rcjcooke/apfc/README.md

# apfc
Aeroponics Personal Food Computer
