rcjcooke/apfc/software/aero_ctrl/README.md

# Aeroponics Controller

## References
* [Using Arduino EEPROM for persistent storage of data](https://docs.arduino.cc/learn/built-in-libraries/eeprom)
* [Using the Gradia Flow Sensor](https://forum.arduino.cc/t/flow-meter-with-arduino/964481/15)
* [Using namespaces to group related variables and functions for interrupt routines](https://forum.arduino.cc/t/embedding-interrupts-and-isr-in-a-class/326121/11)
* [Using Lambdas in C++](https://docs.microsoft.com/en-us/cpp/cpp/lambda-expressions-in-cpp?view=msvc-170)
* [Basic lambda implementation without libraries](https://forum.arduino.cc/t/are-anonymous-function-or-lambda-possible-with-uno-yes-solved/420186/13)
* [Using an industrial pressure sensor](https://www.youtube.com/watch?v=junu_66G_QQ)
* [Depth sensor A02YYUW reference - closest I could find to a datasheet](https://wiki.dfrobot.com/_A02YYUW_Waterproof_Ultrasonic_Sensor_SKU_SEN0311#target_0)
* [Library for setting up serial interfaces on other arduino pins](https://docs.arduino.cc/learn/built-in-libraries/software-serial)
* [Serial comms between a Raspberry Pi and an Arduino](https://roboticsbackend.com/raspberry-pi-arduino-serial-communication/)
