rcjcooke/apfc/hardware/datasheets/201801291535346544.jpg

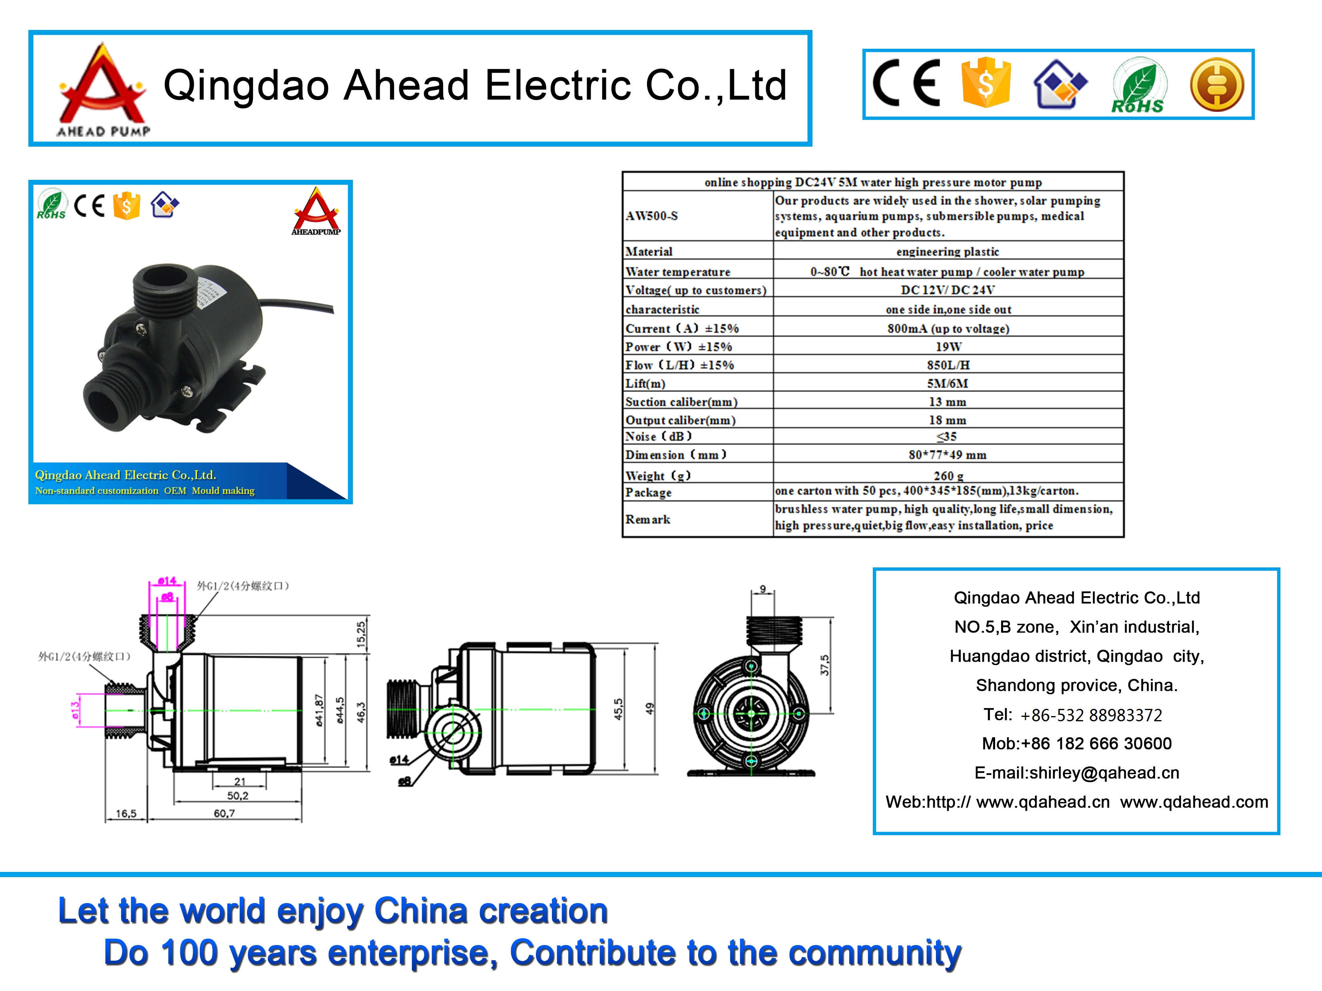
hardware/datasheets/201801291535346544.jpg
