rcjcooke/apfc/V1 BOM.xlsx

Sheet: BOM
Part Description | Manufacturer | Name | Model # | Supplier | # | # / pkg | items | Price / pkg | Total
HPA Irrigation Pump | Aquatec | Aquatec CDP 8800 | 8852-2J03-B424 |  | 1 | 1 | 1 |  | £0.00
3/4" FBSP to 1/4" Push Fit adaptor | John Guest | John Guest Tap Adaptor Flat End 1⁄4″ × 3⁄4″ (BSP Thread) | CI320816FS | Amazon (https://www.amazon.co.uk/John-Guest-BSP-Push-Adapter/dp/B0087OSUY4) | 1 | 1 | 1 | £5.99 | £5.99
1" FBSP to 3/4" MBSP adaptor | BFG | Brass Bush BSP REDUCING Reducer Connector (1"F x 3/4"M) |  | Amazon (https://www.amazon.co.uk/gp/product/B079L84FT8/ref=crt_ewc_title_oth_1) | 1 | 1 | 1 | £7.49 | £7.49
UV Water steriliser |  | UV Water Sterilizer | SDE-011PH | Amazon (https://www.amazon.co.uk/FINERFILTERS-Ultraviolet-Disinfection-Stainless-Sterilizer/dp/B08S7MCFQY) | 1 | 1 | 1 | £48.99 | £48.99
Accumulator Tank | Pressurewave | 8L Accumulation Tank 10bar max working pressure | MTPA-8HL-100BT-1.9-SSC-CSS-AMD-PW (https://www.globalwatersolutions.com/products/pressure-tanks/pump-applications/pressurewave/) | Anglian Plumbing | 1 | 1 | 1 | £54.84 | £54.84
Various fittings + valves | CESFONJER | CESFONJER RO Water Filter Fitting, 1/4" Pushfit Straight Connector for Water Pipe, Push in to Connect Water Tube Fitting Set Pack of 20(Y+T+I+L Type Combo + Shut-Off Valve) |  | Amazon (https://www.amazon.co.uk/gp/product/B07GS1HKCZ/ref=crt_ewc_title_oth_2) | 1 | 20 | 20 | £11.99 | £11.99
Pressure Gauge | Finerfilters | Pressure gauge with 1/4" push fit connections | 5060513511887 | Amazon (https://www.amazon.co.uk/Pressure-Aquatic-Domestic-Connection-Finerfilters/dp/B078WCFHNM) | 1 | 1 | 1 | £8.99 | £8.99
Pressure sensor | Ausla | Pressure Sensor, PSI Pressure Transmitter, G1 / 4 Inch 5 V Transducer for Water Gas Oil (0-150 PSI) | DE-GS07381 | Amazon (https://www.amazon.co.uk/Pressure-pressure-transmitter-transducer-0-100PSI/dp/B0811HPGZ3) | 1 | 1 | 1 | £16.29 | £16.29
G1/4 Female to 1/4" Push Fit adaptor | Sourcingmap | sourcingmap 1/4-inch Push Fit Tube x G1/4 Female Thread Quick Connect 5pcs | ‎A17040800ux1814 | Amazon (https://www.amazon.co.uk/sourcingmap%C2%AE-4-inch-Female-Thread-Connect/dp/B073V1DQFW/ref=sr_1_3) | 1 | 5 | 5 | £8.49 | £8.49
Flow sensor | Gredia | GREDIA 1/4" Quick Connect Water Flow Sensor Food-grade Switch Hall Effect Flowmeter Fluid Meter Counter 0.3-6L/min (Pack of 2) | ‎GR-402BP2 | Amazon (https://www.amazon.co.uk/gp/product/B07RD4JXLY) | 1 | 2 | 2 | £8.49 | £8.49
1/4" tubing white | John Guest | 1/4 FRIDGE FILTER TUBING LLDPE WATER PIPE John Guest JG 10m WHITE by John Guest | PE08BI0500FBX10M | Amazon (https://www.amazon.co.uk/FRIDGE-FILTER-TUBING-LLDPE-WATER/dp/B00JF1O7UY/ref=sr_1_1) | 1 | 1 | 1 | £7.98 | £7.98
Pressure Release Valve 8 bar | Afriso | 1/2" x 3/4" Boiler Safety Pressure Release Relief Reducing Valve FxF Female 8 Bar | 642415254519 | Amazon (https://www.amazon.co.uk/Boiler-Safety-Pressure-Release-Reducing/dp/B079Q8RVYR/ref=sr_1_5) | 1 | 1 | 1 | £14.99 | £14.99
1/2" MBSP to 1/2" MBSP adaptor | CYUaoao | CYUaoao Faucet Adapter 3Pcs Hex Nipple Brass Pipe Fitting 1/2"(20mm) BSP Male to Male Straight Pipe Hex Fitting Heavy Pipe Metals External Hex Nipple for Connecting to Female Threaded Pipes (DN15) |  | Amazon (https://www.amazon.co.uk/gp/product/B0995N9WZD/ref=sw_img_1?smid=AGFU543GC4OL1&psc=1) | 1 | 3 | 3 | £8.09 | £8.09
1/2" FBSP to 1/4" Push Fit adaptor | John Guest | JOHN GUEST PIPE CONNECTOR. Push-fit Tube O.D. 1/4" to 1/2" BSP Thread. Speedfit Part No CI320814S. Inch Size Threaded Acetal Fittings for Drinks Dispensers and Pure Water. |  | Amazon (https://www.amazon.co.uk/CONNECTOR-Push-fit-Speedfit-CI320814S-Dispensers/dp/B00HVFWE1K) | 6 | 1 | 6 | £6.24 | £37.44
3/4" MBSP to 1/2" MBSP adaptor | Her Kindness | Brass Hexagon Reducer 3/4” to 1/2” BSP, Her Kindness 2 Pcs Brass Bsp Reducing Connector, 1/2 inch Male to 3/4 inch Adaptor, Brass Reducing Double Nipple 3/4" x 1/2" Male to Male |  | Amazon (https://www.amazon.co.uk/gp/product/B08GC8SXYL/ref=sw_img_1?smid=ANDZAHJFWVWB4&psc=1) | 1 | 1 | 1 | £8.99 | £8.99
Used water filter | Sinolofty | Sinolofty Pipeline Filter, 1/2 Inch Water Pump Filter with 100 Mesh Stainless Steel Strainer, Inline Mesh Screen, Water Pump Filter for Garden Irrigation |  | Amazon (https://www.amazon.co.uk/gp/product/B097H5L5NC/ref=crt_ewc_title_oth_1) | 1 | 1 | 1 | £9.59 | £9.59
Tank pump | HSeaMall | HSEAMALL Brushless Submersible Water Pump DC 12V Amphibious Pump 800L/H 5M for Pond Aquarium Fish Tank Solar Fountain Pool Water Circulation System |  | Amazon (https://www.amazon.co.uk/gp/product/B07L89V1N6/ref=crt_ewc_title_dp_2) | 2 | 1 | 2 | £17.99 | £35.98
1/4" Solenoid valve | Gredia | GREDIA 1/4" DC 12V Solenoid Valve N/C Normally Closed Water Inlet Flow Switch | GRS01 | Amazon (https://www.amazon.co.uk/gp/product/B08KS5MMYK/ref=sw_img_1) | 3 | 1 | 3 | £6.59 | £19.77
1/4" Push Fit 90 elbows | CESFONJER | CESFONJER 1/4-1/4, 90° Elbow Connector | 1/4" to 1/4" Pushfit Fittings | Ro Water Filter Fitting | for Water Filter Dispensers and Reverse Osmosis (12 Pcs) |  | Amazon (https://www.amazon.co.uk/dp/B07QLX7VT5/ref=sspa_dk_detail_0) | 2 | 12 | 24 | £7.99 | £15.98
1/4" Push Fit Tee joints | CESFONJER | CESFONJER Tee 1/4-Inch Reverse Osmosis Tubing Connector | Fridge Filter Plumbing Kit | 1/4" To 1/4" Pushfit Fittings | ro water filter fitting | for Water Filter Dispensers and Reverse Osmosis(10 Pcs) |  | Amazon (https://www.amazon.co.uk/KINYOOO%C2%AE-Connector-Plumbing-Fittings-Dispensers/dp/B07QLX7NYV) | 1 | 10 | 10 | £7.99 | £7.99
Spray nozzles | Sourcingmap | sourcing map G1/4 Mist Nozzle - 0.7mm Orifice Dia Brass Fine Atomizing Spray Tip |  | Amazon (https://www.amazon.co.uk/gp/product/B07W61FVC7/ref=crt_ewc_title_oth_1) | 4 | 1 | 4 | £9.49 | £37.96
1/4" tubing red | John Guest | 1/4" FRIDGE FILTER TUBING LLDPE WATER PIPE John Guest JG 15m RED |  | Amazon (https://www.amazon.co.uk/gp/product/B00JF210DK/ref=crt_ewc_title_oth_1) | 1 | 1 | 1 | £8.10 | £8.10
Tank Depth sensors | DollaTek | DollaTek DC 5V Waterproof Ultrasonic Distance Sensor Measuring Ranging Transducer Module with 2.5M Cable for Arduino |  | Amazon (https://www.amazon.co.uk/gp/product/B07PMGJ231/ref=crt_ewc_title_oth_1) | 3 | 1 | 3 | £10.99 | £32.97
Tanks (Used Solution, Mixing) | IKEA | SOCKERBIT Storage box with lid, grey-green, 38x25x15 cm | 605.140.68 | IKEA (https://www.ikea.com/gb/en/p/sockerbit-storage-box-with-lid-grey-green-60514068/) | 2 | 1 | 2 | £6.00 | £12.00
Plant Bed Tank | IKEA | SAMLA Box, transparent, 78x56x43 cm/130 l | 901.029.71 | IKEA (https://www.ikea.com/gb/en/p/samla-box-transparent-90102971/) | 1 | 1 | 1 | £13.50 | £13.50
Drain flange | Kockney Koi Yamitsu | 1.5" Solvent Weld Flange Tank/Liner Connector Pond Fitting | KKTLC1.5 | Discount Leisure Products (https://www.discountleisureproducts.co.uk/pond-supplies-c1/pond-pipe-and-fittings-c20/kockney-koi-yamitsu-1-5-solvent-weld-flange-tank-liner-connector-pond-fi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) | 1 | 1 | 1 | £4.49 | £4.49
Drain pipe | DLP | 1.5" (40mm) Solvent Weld Pipe 1 metre | W539 | Discount Leisure Products (https://www.discountleisureproducts.co.uk/pond-supplies-c1/pond-pipe-and-fittings-c20/solvent-weld-pipe-fittings-c89/dlp-1-5-43mm-solvent-weld-pipe-1-metre-p1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) | 1 | 1 | 1 | £4.29 | £4.29
RunOff Drain Tank Connector | Kockney Koi Yamitsu | 1.5" Solvent Weld Threaded Tank Connector Fish Pond Fitting | KK158 | Discount Leisure Products (https://www.discountleisureproducts.co.uk/pond-supplies-c1/pond-pipe-and-fittings-c20/solvent-weld-pipe-fittings-c89/kockney-koi-yamitsu-1-5-solvent-weld-thre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) | 1 | 1 | 1 | £1.89 | £1.89
1.5" drain pipe 90 elbows | DLP | 1.5" Solvent Weld 90 Degree Swept Elbow/Bend | W79 | Discount Leisure Products (https://www.discountleisureproducts.co.uk/pond-supplies-c1/pond-pipe-and-fittings-c20/solvent-weld-pipe-fittings-c89/dlp-1-5-solvent-weld-90-degree-swept-elbo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) | 2 | 1 | 2 | £1.99 | £3.98
Drain pipe glue | Hunter Plastics | 125ml Solvent Pipe Glue/Cement | KKGLUE125ML | Discount Leisure Products (https://www.discountleisureproducts.co.uk/pond-supplies-c1/pond-pipe-and-fittings-c20/solvent-weld-glue-c85/hunter-plastics-125ml-solvent-pipe-glue-cement-p1454) | 1 | 1 | 1 | £6.49 | £6.49
Filter pipes (1/2" 60mm MBSPT at both ends) | Double4love | Double4love 1/2"X60mm Barrel Nipple Stainless Steel 316L BSPT Threaded |  | Amazon (https://www.amazon.co.uk/gp/product/B07FP7MNB5/ref=ppx_yo_dt_b_asin_title_o00_s00) | 2 | 1 | 2 | £8.87 | £17.74
1/4" pipe glands | Sourcingmap | sourcing map 8Pcs PG7 Cable Gland Waterproof Connector Plastic Wire Glands Joints White for 3-6.5mm Dia Wires | A18032200ux0204 | Amazon (https://www.amazon.co.uk/gp/product/B07DC74Q7B/ref=ppx_yo_dt_b_asin_title_o03_s00) | 2 | 8 | 16 | £7.49 | £14.98
12V power supply 90W | RS Pro | RS PRO DIN Rail Power Supply 120 → 370 V dc, 85 → 264 V ac Input, 12V Output, 7.5A 90W | LI100-20B12PR2 | RS (https://uk.rs-online.com/web/p/din-rail-power-supplies/1904201) | 1 | 1 | 1 | £30.00 | £30.00
24VAC Transformer 100W | Comatec | Comatec 100VA DIN Rail Transformer, 230V ac Primary, 24V ac Secondary | TBD2.0100.24.F8 | RS (https://uk.rs-online.com/web/p/din-rail-transformers/8919236) | 1 | 1 | 1 | £53.90 | £53.90
5V power supply 15W | RS Pro | RS PRO DIN Rail Power Supply 120 → 370 V dc, 85 → 264V ac Input, 5V Output, 3A 15W | 190-4190 | RS (https://uk.rs-online.com/web/p/din-rail-power-supplies/1904190) | 1 | 1 | 1 | £17.05 | £17.05
DIN Rail | Fibox | Fibox Steel Unslotted Din Rail, Top Hat Compatible, 335mm x 35mm x 8mm | EKV 32 DIN-35 rail | RS (https://uk.rs-online.com/web/p/din-rails/1882550) | 1 | 1 | 1 | £5.18 | £5.18
White 50mm cable trunking | Wickes | Wickes Maxi Trunking - White 50 x 50mm x 2m | 109653 | Wickes (https://www.wickes.co.uk/Wickes-Maxi-Trunking---White-50-x-50mm-x-2m/p/109653) | 2 | 1 | 2 | £14.90 | £29.80
5 Stage RO system | Finerfilters | 5 STAGE REVERSE OSMOSIS SYSTEM WITH BOOSTER PUMP 50GPD ¦ UNDER SINK HOME DOMESTIC | FF-RO-SYST-D5-PUMP | Finerfilters (https://www.finerfilters.co.uk/finerfilters-domestic-5-stage-reverse-osmosis-unit-with-pump.html) | 1 | 1 | 1 | £139.99 | £139.99
Additional RO membrane | Finerfilters | REVERSE OSMOSIS ADDITIONAL MEMBRANE UPGRADE KIT | FF-RO-MEMB-UPG-KIT | Finerfilters (https://www.finerfilters.co.uk/reverse-osmosis-additional-membrane-upgrade-kit.html) | 1 | 1 | 1 | £27.99 | £27.99
Supply and Waste Water Tanks | Tanks Direct | 28 LITRE WATER TANK, TOWER | T28TNA4V | TanksDirect (https://www.tanks-direct.co.uk/28-litre-water-tank-tower/p6200) | 2 | 1 | 2 | £57.60 | £115.20
One way gas valve for nutrient flasks | LiebeWH | 12PCS Aquarium Check Valve Non Return Flows Control Check Valve One Way Air Valve PP for Fish Tank Chemical Industry (4mm) | ‎LiebeWHrb18hpo4zx2561-11 | Amazon (https://www.amazon.co.uk/dp/B0B15HJTC5/ref=sspa_dk_detail_10) | 1 | 12 | 12 | £6.34 | £6.34
Nutrient bottles | Octopus | Wide-neck bottles with screw caps, chemical bottle, laboratory bottle with lid, storage container for laboratory, kitchen or hobby, pack of 10, transparent, 10x 500 ml | PLFWH500-10 | Amazon (https://www.amazon.co.uk/dp/B076H8M48N/ref=sspa_dk_detail_4) | 1 | 10 | 10 | £32.10 | £32.10
Nutrient pumps | Gikfun | Gikfun 12V Peristaltic Liquid Pump Dosing Pump with Replacement for Aquarium Lab Analytical DIY EK1978 (2) | EK1978 | Amazon (https://www.amazon.co.uk/gp/product/B0BNH5S25M/ref=sw_img_1) | 4 | 2 | 8 | £19.98 | £79.92
Nutrient pipe |  | JINchao-clear plastic hose 1/5/10Meters Silicone Tube, 2x4mm, High And Low Temperature Resistance Tasteless Transparent Hose Pipe Plastic Flexible Water Pipe (Color : Green, Length : 10Meters) | Pangocho | Amazon (https://www.amazon.co.uk/gp/product/B09291JJHB/ref=sw_img_1) | 1 | 1 | 1 | £18.47 | £18.47
RO Water tank air valve extension | Zsanhua | Zsanhua Tire Valve Extension 2 Pieces 180 mm, Flexible Valve Stem Extenders with 2 Pieces 90 Degree Brass Tire Valve Extension Adaptor Compatible for Cars Truck Motorcycle Bike Scooter | DG257 | Amazon (https://www.amazon.co.uk/Zsanhua-Extension-Extenders-Compatible-Motorcycle/dp/B0BG4CFX3J) | 1 | 2 | 2 | £8.99 | £8.99
Stop cap for waste water valve | ‎LP Supplies | Brass Blanking Caps 1/2" (Pack of 3) with Washers for 15mm Compression Fittings | 10070227 | Amazon (https://www.amazon.co.uk/dp/B083SMC9VD) | 1 | 3 | 3 | £4.39 | £4.39
TDS sensors for filter change checking | CQRobot | CQRobot Ocean: TDS (Total Dissolved Solids) Meter Sensor Compatible with Raspberry Pi/Arduino Board. for Liquid Quality Analysis Teaching, Scientific Research, Laboratory, Online Analysis, etc. | CQRSENTDS01 | Amazon (https://www.amazon.co.uk/dp/B08KXRHK7H) | 2 | 1 | 2 | £10.99 | £21.98
Waste water tap | RMTL | RMTL Outdoor Garden Tap Hose Union Bib Tap 1/2inch BSP with Compression Wallplate Elbow, Through The Wall 15mm Copper Tube (Single Bib Tap) |  | Amazon (https://www.amazon.co.uk/dp/B0B36HNGV4?th=1) | 1 | 1 | 1 | £8.99 | £8.99
Plumbing bracket mounting screws | Sourcingmap | Sourcingmap 50 Pcs M2 x 15mm Stainless Steel Phillips Round Head Self Tapping Screws Bolts | a16072200ux0833 | Amazon (https://www.amazon.co.uk/gp/product/B01LXFY42N/ref=ppx_yo_dt_b_asin_title_o02_s00?ie=UTF8&psc=1) | 1 | 50 | 50 | £5.99 | £5.99
Water temperature sensor | Aideepen | Aideepen 5 x DS18B20 2m Cable Temperature Digital Thermal Probe Sensor Stainless Steel Probe, Accurate Reading, Measure Temperature -55°C to +125°C | A70110795UK | Amazon (https://www.amazon.co.uk/Aideepen-DS18B20-Temperature-Stainless-Accurate/dp/B08DJ5D5WM) | 1 | 5 | 5 | £11.99 | £11.99
Nutrient solution heater | Hidom | Hidom 25w Submersible Aquarium Fish Tank Shockproof Thermostat Heater - Adjustable Temperature HT-2025 | ‎HT-2025-U | Amazon (https://www.amazon.co.uk/gp/product/B011G5B7EA) | 1 | 1 | 1 | £10.45 | £10.45

Sheet: Power Supplies
 |  | V | DC/AC | Power / W | # | Total Power / W | Total Current / A
Irrigation | Valve | 12 | DC | 4.8 | 2 | 9.6 | 0.40 | V / V | DC | AC | Power / W | Current / A
 | Pump | 24 | AC | 40 | 1 | 40 | 1.67 | 12 | DC | 47.6 | 3.97
 | Flow Sensor | 5 | DC |  |  | 0 | 0.00 | 5 | DC | 0 | 0.00
 | Pressure Sensor | 5 | DC |  |  | 0 | 0.00 | 240 | AC | 14 | 0.06
RunOff Recycling | Pump | 12 | DC | 19 | 1 | 19 | 1.58 | 24 | AC | 40 | 1.67
 | UV Lamp | 240 | AC | 14 | 1 | 14 | 0.06 |  |  | 101.6
Nutrient Mixing | Pump | 12 | DC | 19 | 1 | 19 | 1.58

Sheet: Electronics
Part Description | Manufacturer | Name | Model # | Supplier | # | Price / unit | Total
Solenoid MOSFETS | Onsemi | N-Channel MOSFET, 2 A, 400 V, 3-Pin IPAK onsemi FDU3N40TU | FDU3N40TU | RS (https://uk.rs-online.com/web/p/mosfets/8070701) | 10 | £0.66 | £6.60
IR Camera | Raspberry Pi | Raspberry Pi NoIR Camera Module V2.1 |  | PiHut (https://thepihut.com/collections/raspberry-pi-camera/products/raspberry-pi-noir-camera-module)
