rcjcooke/apfc/hardware/laserCutDrawings/WP-FrontMountPlate.dxf

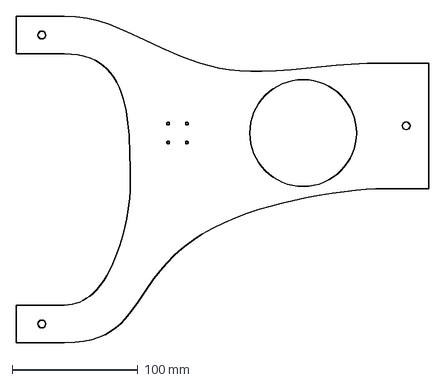
[picture p2: CAD file, 2025-07-20]
hardware/laserCutDrawings/WP-FrontMountPlate.dxf
328.4 x 260.0 mm
