rcjcooke/apfc/hardware/laserCutDrawings/WP-FP-Bottom-Sketch.dxf

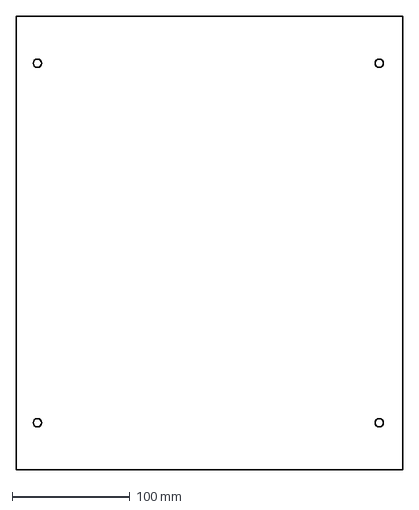
[picture p3: CAD file, 2023-04-30]
hardware/laserCutDrawings/WP-FP-Bottom-Sketch.dxf
328.0 x 385.0 mm
