rcjcooke/apfc/hardware/laserCutDrawings/I_Management_FMP.dxf

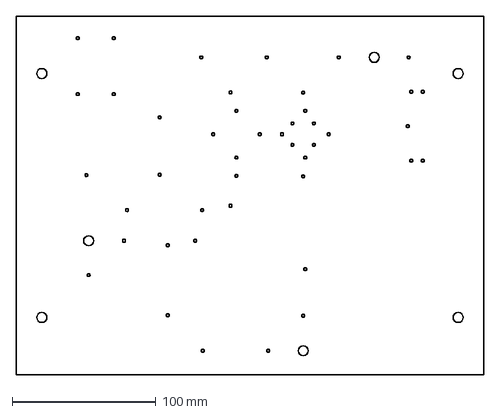
[picture p4: CAD file, 2023-04-30]
hardware/laserCutDrawings/I_Management_FMP.dxf
326.0 x 250.0 mm
