rcjcooke/apfc/hardware/laserCutDrawings/WP-FP-Top-Sketch.dxf

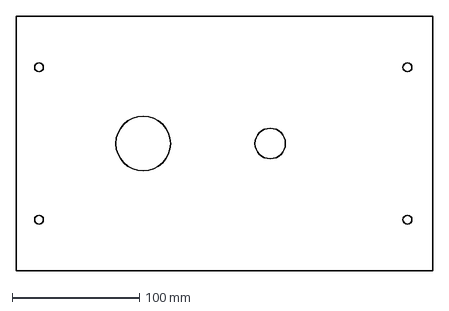
[picture p5: CAD file, 2023-04-30]
hardware/laserCutDrawings/WP-FP-Top-Sketch.dxf
328.0 x 200.0 mm
