rcjcooke/apfc/hardware/laserCutDrawings/I_Management_FP.dxf

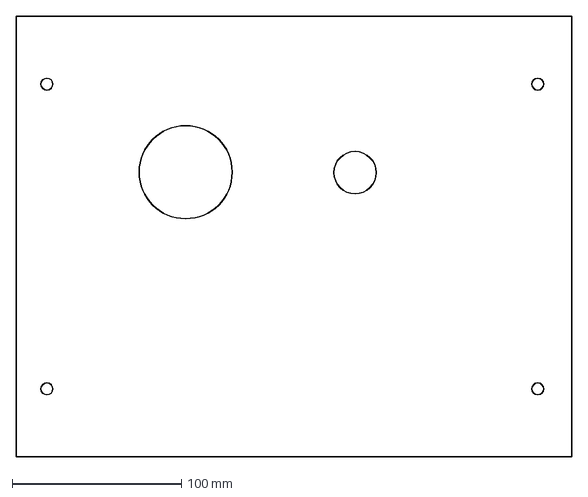
[picture p6: CAD file, 2023-04-30]
hardware/laserCutDrawings/I_Management_FP.dxf
328.0 x 260.0 mm
