rcjcooke/apfc/hardware/436450200.stp

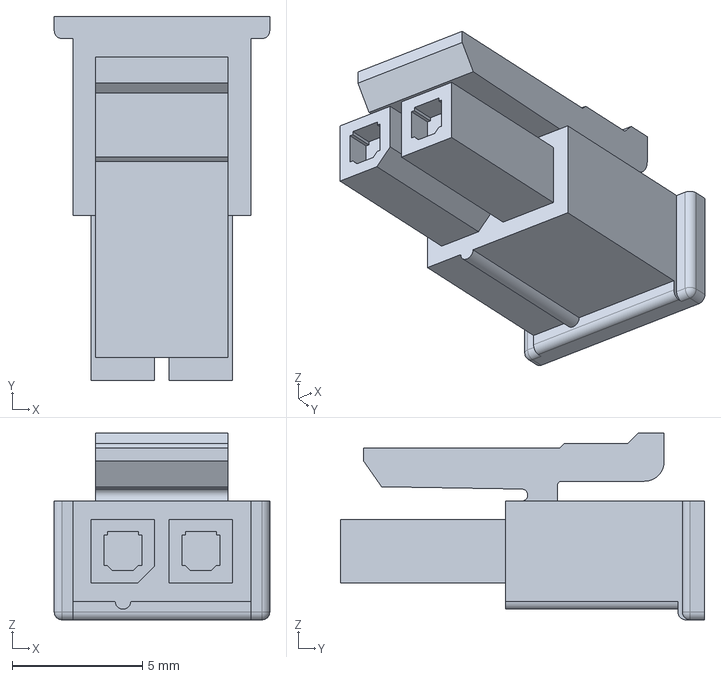
[picture p7: CAD file, 2022-09-20]
hardware/436450200.stp
8.29 x 14.0 x 7.18 mm
