rcjcooke/apfc/electronics/Nutrient Management Control v2.2.brd

## EAGLE design electronics/Nutrient Management Control v2.2.brd (2025-07-20)

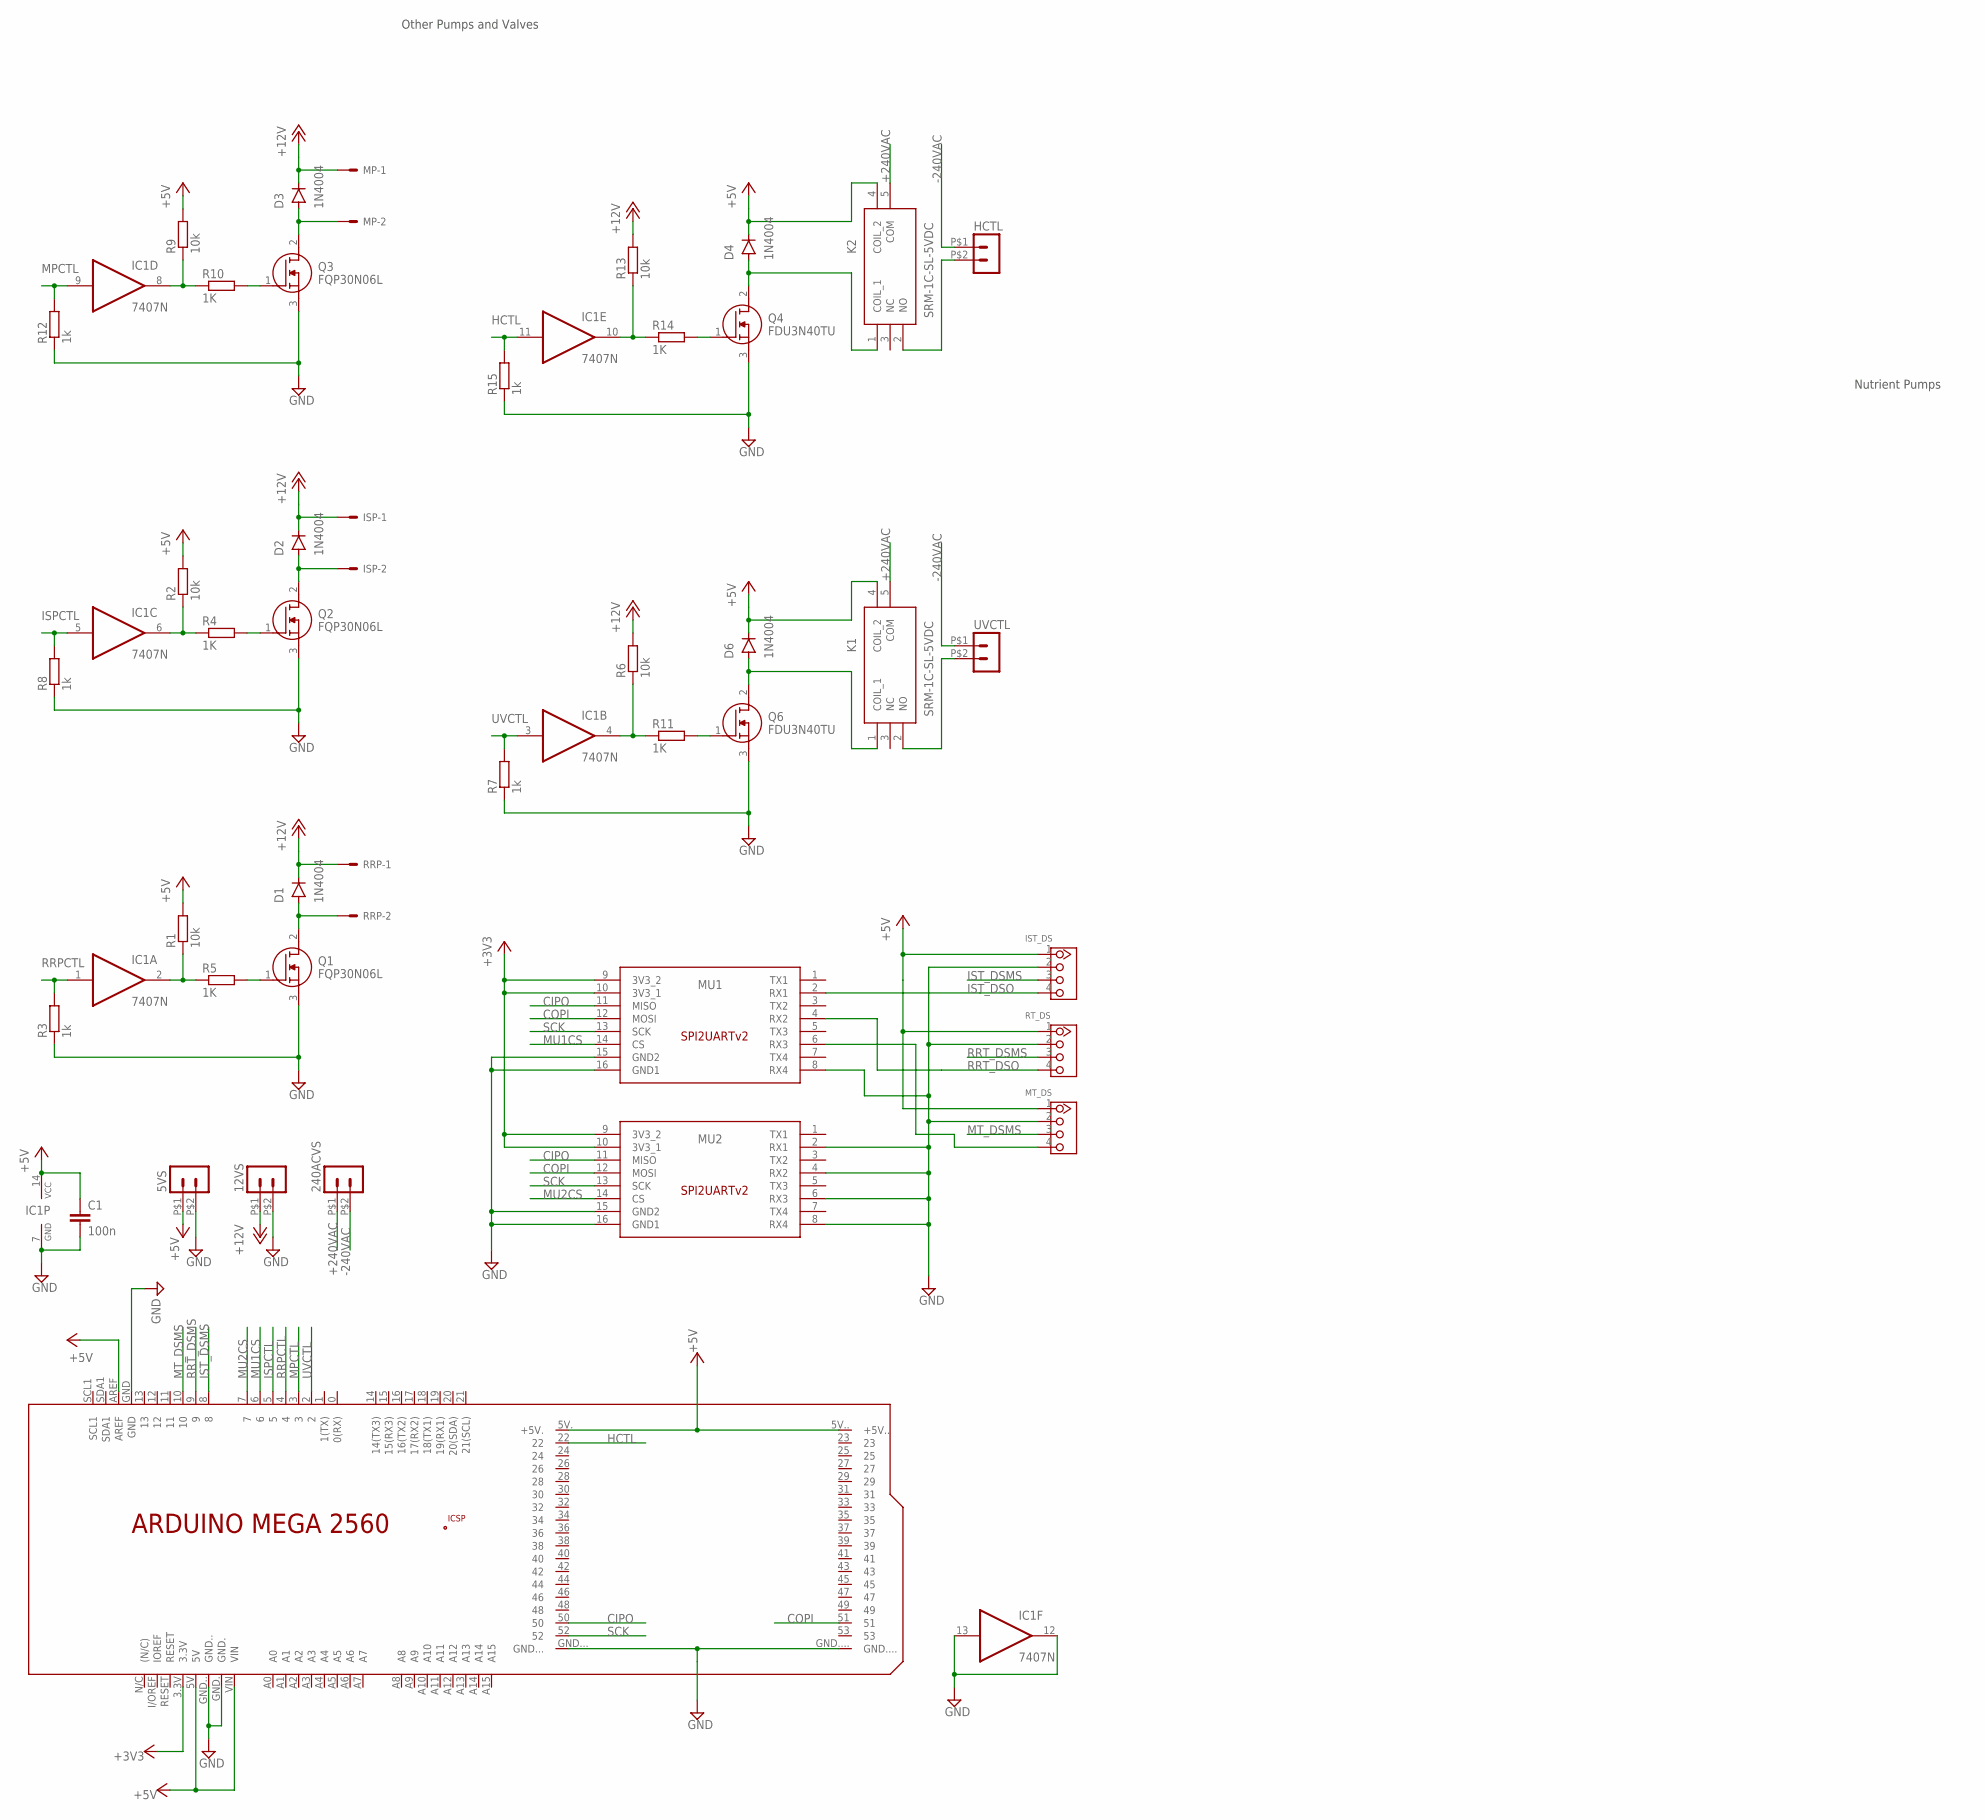
[picture p8: schematic Nutrient Management Control v2.2.sch]

Parts:
5VS, 12VS, 240ACVS: HEADER_POS2_43650-0215; 43650-0215
C1: 100n; C050-024X044
D1, D2, D3, D4, D6: 1N4004; DO-41
HCTL: HEADER_POS2_43650-0215; 43650-0215
IC1: 7407N; DIL14
ISP: JST-XH-02-PIN-LONG-PAD; JST-XH-02-PACKAGE-LONG-PAD
IST_DS: 4P-2.0-90D; HW4-2.0-90D
K1, K2: SRM-1C-SL-5VDC; SRM1CSL5VDC
MP: JST-XH-02-PIN-LONG-PAD; JST-XH-02-PACKAGE-LONG-PAD
MT_DS: 4P-2.0-90D; HW4-2.0-90D
MU1, MU2: SPI2UART_HEADERS; SPI2UARTV2
PCB2: ARDUINO_MEGA2560_SHIELD
Q1, Q2, Q3: FQP30N06L; TO254P470X1016X2019-3P
Q4, Q6: FDU3N40TU; TO229P250X658X985-3P
R1, R2, R6, R9, R13: 10k; 0204/7
R3, R7, R8, R12, R15: 1k; 0204/7
R4, R5, R10, R11, R14: 1K; 0204/7
RRP: JST-XH-02-PIN-LONG-PAD; JST-XH-02-PACKAGE-LONG-PAD
RT_DS: 4P-2.0-90D; HW4-2.0-90D
UVCTL: HEADER_POS2_43650-0215; 43650-0215

Connections:
+3V3: MU1.9 (3V3_2), MU1.10 (3V3_1), MU2.9 (3V3_2), MU2.10 (3V3_1), PCB2.3.3V
+5V: 5VS.P$1 (1), C1.1, D4.C, D6.C, IC1.14 (VCC), IST_DS.1, K1.4 (COIL_2), K2.4 (COIL_2), MT_DS.1, PCB2.5V, PCB2.5V. (+5V.), PCB2.5V.. (+5V..), PCB2.AREF, PCB2.VIN, R1.2, R2.2, R9.2, RT_DS.1
+12V: 12VS.P$1 (1), D1.C, D2.C, D3.C, ISP.1, MP.1, R6.2, R13.2, RRP.1
+240VAC: 240ACVS.P$1 (1), K1.5 (COM), K2.5 (COM)
-240VAC: 240ACVS.P$2 (2), HCTL.P$1 (1), UVCTL.P$1 (1)
CIPO: MU1.11 (MISO), MU2.11 (MISO), PCB2.50
COPI: MU1.12 (MOSI), MU2.12 (MOSI), PCB2.51
GND: 5VS.P$2 (2), 12VS.P$2 (2), C1.2, IC1.7 (GND), IC1.12 (O), IC1.13 (I), IST_DS.2, MT_DS.2, MU1.8 (RX4), MU1.15 (GND2), MU1.16 (GND1), MU2.2 (RX1), MU2.4 (RX2), MU2.6 (RX3), MU2.8 (RX4), MU2.15 (GND2), MU2.16 (GND1), PCB2.GND, PCB2.GND., PCB2.GND.., PCB2.GND..., PCB2.GND...., Q1.3 (S), Q2.3 (S), Q3.3 (S), Q4.3 (S), Q6.3 (S), R3.1, R7.1, R8.1, R12.1, R15.1, RT_DS.2
HCTL: IC1.11 (I), PCB2.22, R15.2
ISPCTL: IC1.5 (I), PCB2.5, R8.2
IST_DSMS: IST_DS.3, PCB2.8
IST_DSO: IST_DS.4, MU1.2 (RX1)
MPCTL: IC1.9 (I), PCB2.3, R12.2
MT_DSMS: MT_DS.3, PCB2.10
MU1CS: MU1.14 (CS), PCB2.6
MU2CS: MU2.14 (CS), PCB2.7
unnamed: D2.A, ISP.2, Q2.2 (D)
unnamed: IC1.6 (O), R2.1, R4.1
unnamed: IC1.2 (O), R1.1, R5.1
unnamed: Q2.1 (G), R4.2
unnamed: Q1.1 (G), R5.2
unnamed: D3.A, MP.2, Q3.2 (D)
unnamed: K1.2 (NO), UVCTL.P$2 (2)
unnamed: IC1.8 (O), R9.1, R10.1
unnamed: Q3.1 (G), R10.2
unnamed: D1.A, Q1.2 (D), RRP.2
unnamed: MT_DS.4, MU1.6 (RX3)
unnamed: D4.A, K2.1 (COIL_1), Q4.2 (D)
unnamed: Q6.1 (G), R11.2
unnamed: HCTL.P$2 (2), K2.2 (NO)
unnamed: Q4.1 (G), R14.2
unnamed: IC1.10 (O), R13.1, R14.1
unnamed: IC1.4 (O), R6.1, R11.1
unnamed: D6.A, K1.1 (COIL_1), Q6.2 (D)
RRPCTL: IC1.1 (I), PCB2.4, R3.2
RRT_DSMS: PCB2.9, RT_DS.3
RRT_DSO: MU1.4 (RX2), RT_DS.4
SCK: MU1.13 (SCK), MU2.13 (SCK), PCB2.52
UVCTL: IC1.3 (I), PCB2.2, R7.2

Notes on the sheet:
Nutrient Pumps
Other Pumps and Valves

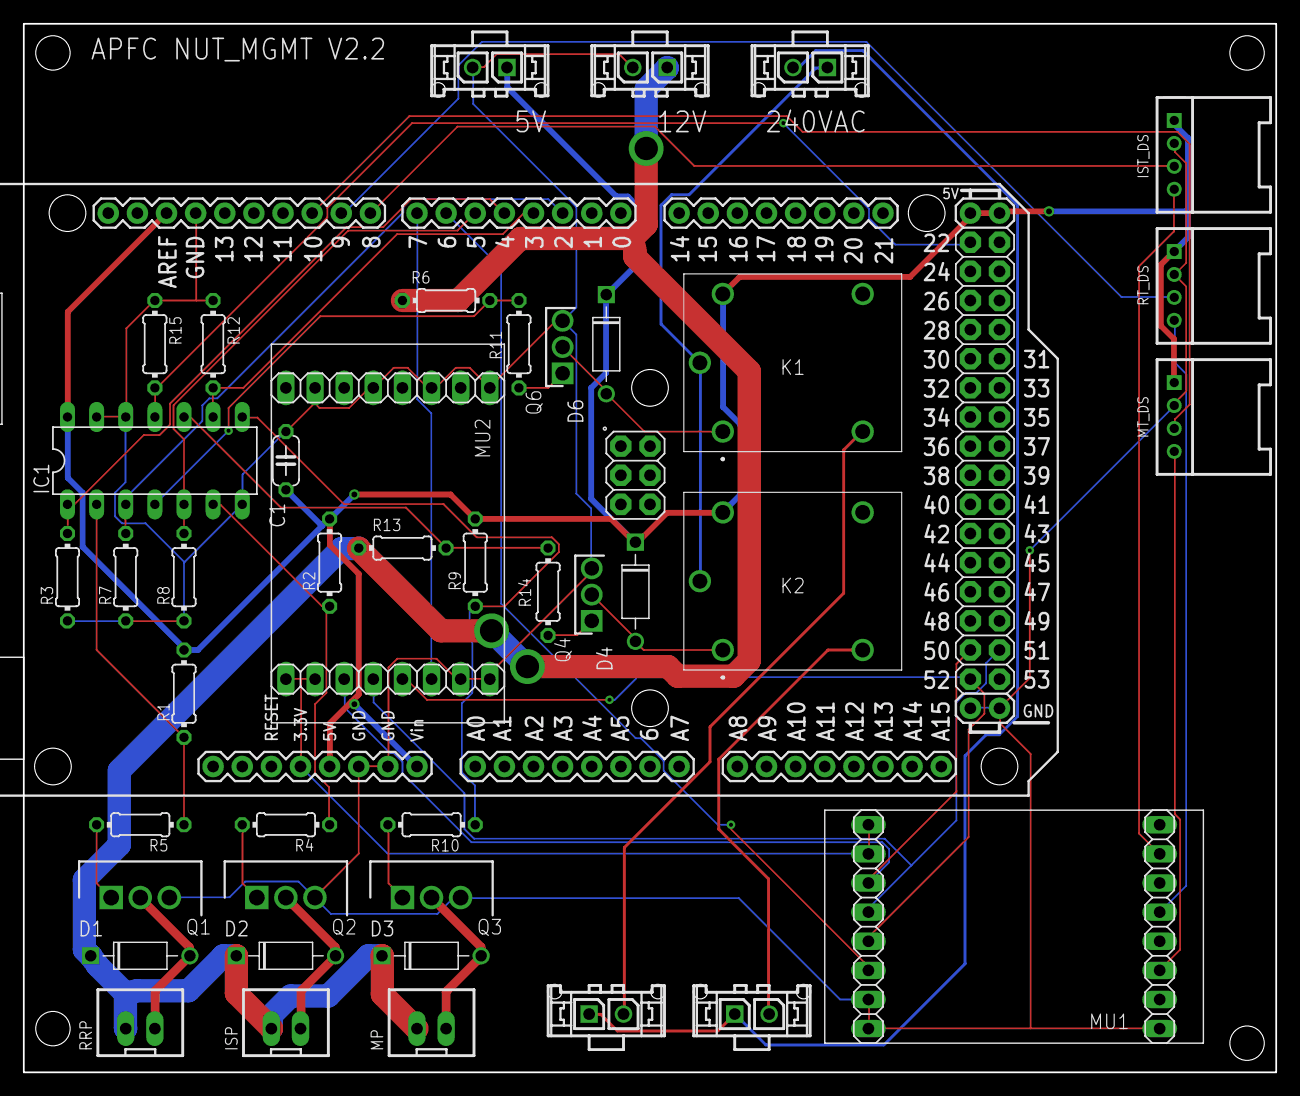
[picture p9: board Nutrient Management Control v2.2.brd from above]

Board: 2 copper layers, 109.2 x 91.4 mm, 43 parts (0 on the bottom side), 39 nets.
