rcjcooke/apfc/electronics/Nutrient Management Control.brd

## EAGLE design electronics/Nutrient Management Control.brd (2024-10-17, an earlier design)

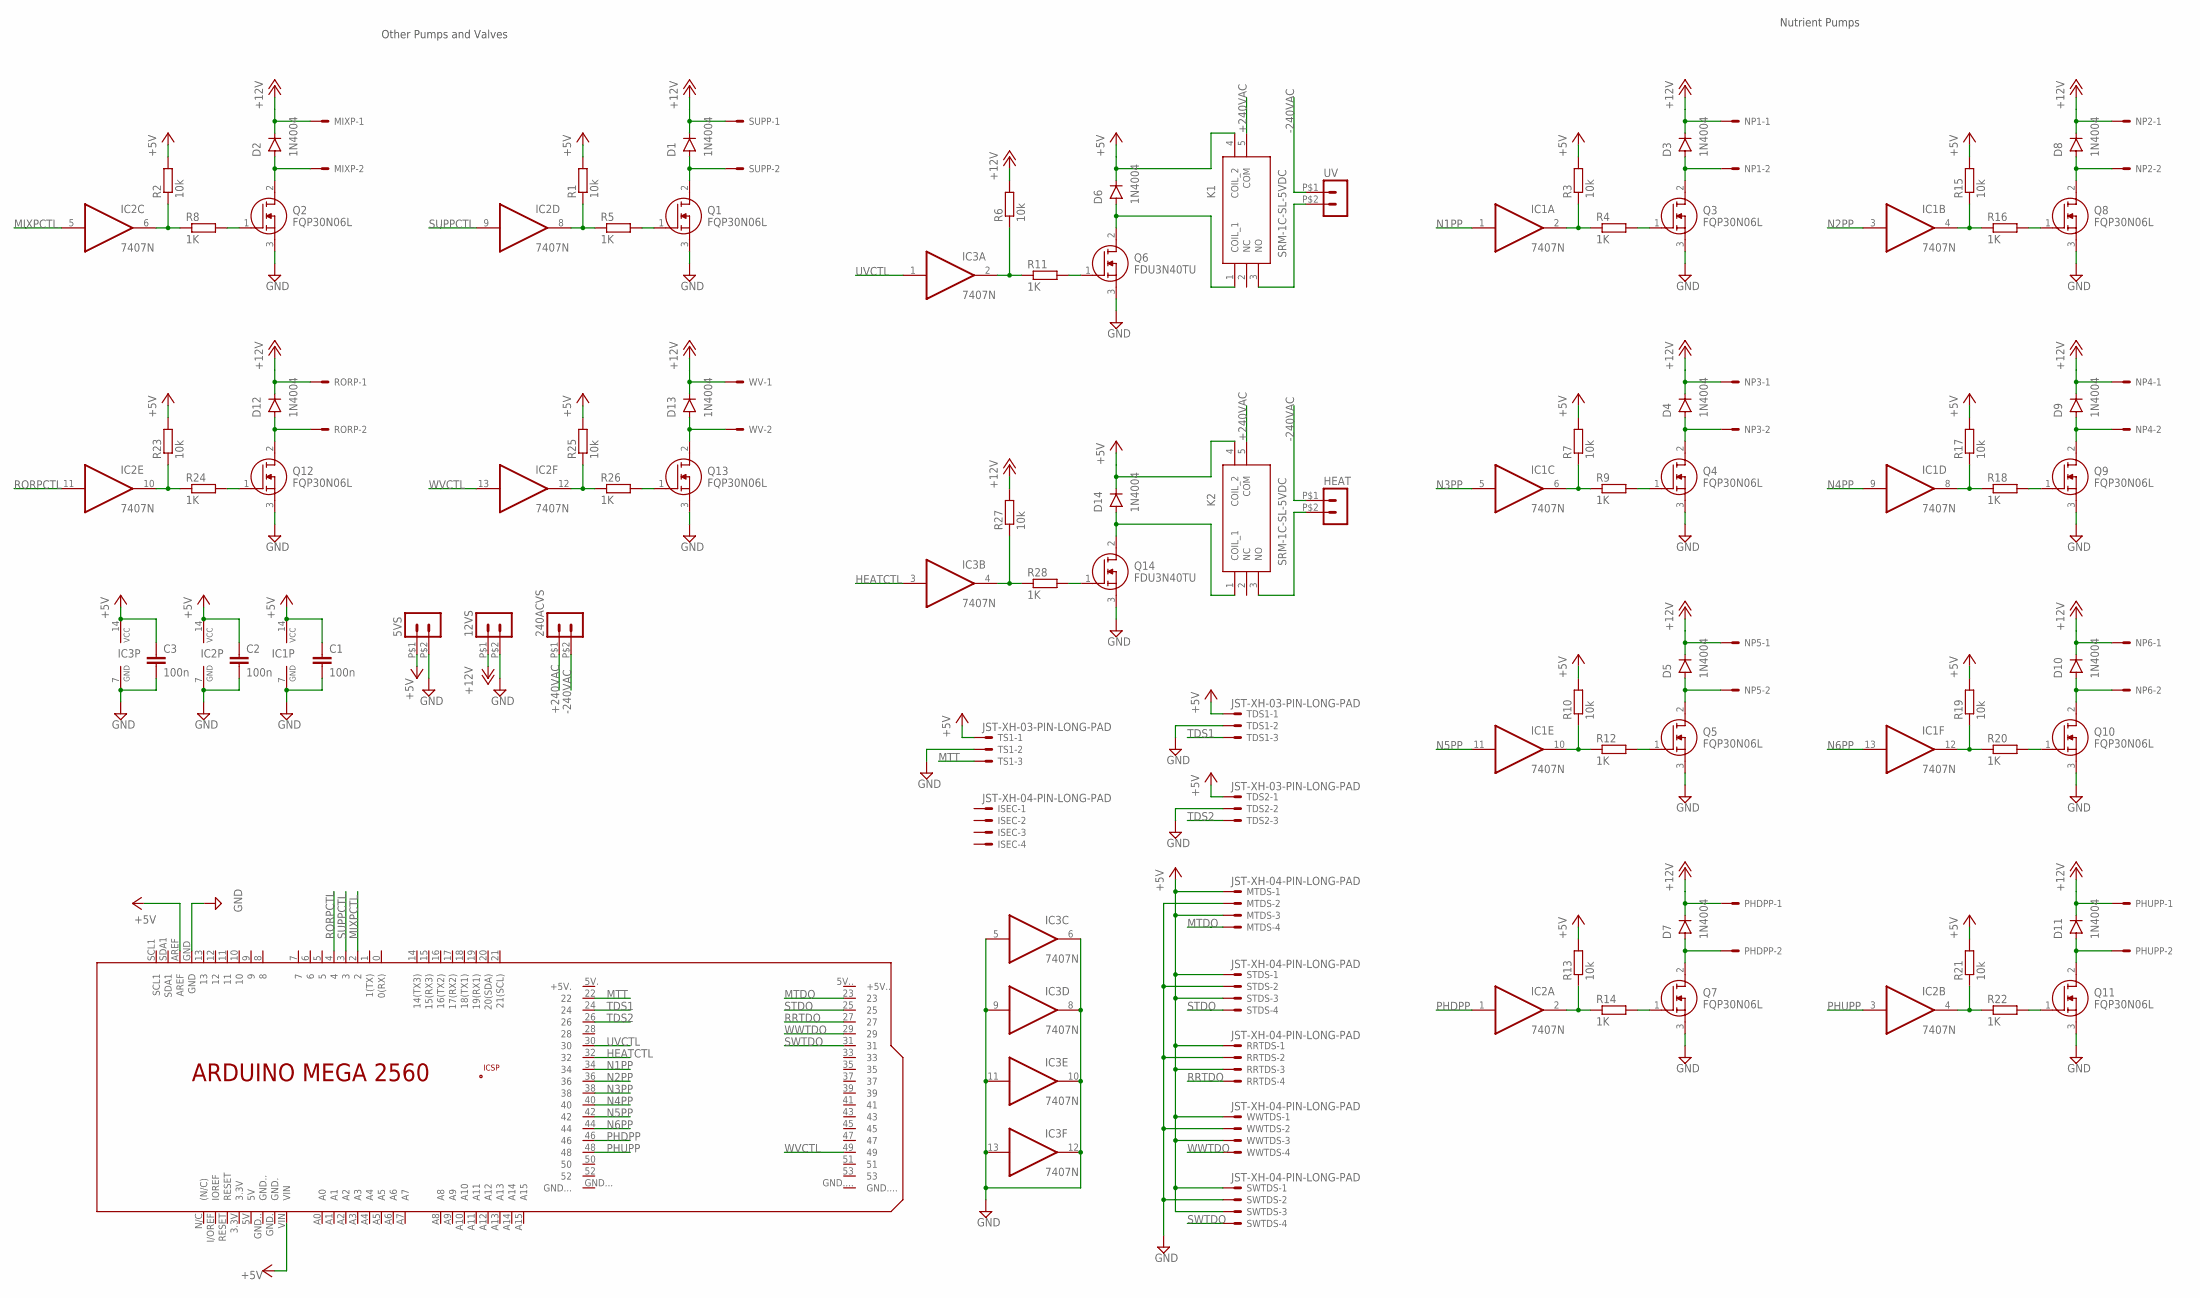
[picture p10: schematic Nutrient Management Control.sch]

Parts:
5VS, 12VS, 240ACVS: HEADER_POS2_43650-0215; 43650-0215
C1, C2, C3: 100n; C050-024X044
D1, D2, D3, D4, D5, D6, D7, D8, D9, D10, D11, D12, D13, D14: 1N4004; DO-41
HEAT: HEADER_POS2_43650-0215; 43650-0215
IC1, IC2, IC3: 7407N; DIL14
ISEC: JST-XH-04-PIN-LONG-PAD; JST-XH-04-PACKAGE-LONG-PAD
K1, K2: SRM-1C-SL-5VDC; SRM1CSL5VDC
MIXP: JST-XH-02-PIN-LONG-PAD; JST-XH-02-PACKAGE-LONG-PAD
MTDS: JST-XH-04-PIN-LONG-PAD; JST-XH-04-PACKAGE-LONG-PAD
NP1, NP2, NP3, NP4, NP5, NP6: JST-XH-02-PIN-LONG-PAD; JST-XH-02-PACKAGE-LONG-PAD
PCB2: ARDUINO_MEGA2560_SHIELD
PHDPP: JST-XH-02-PIN-LONG-PAD; JST-XH-02-PACKAGE-LONG-PAD
PHUPP: JST-XH-02-PIN-LONG-PAD; JST-XH-02-PACKAGE-LONG-PAD
Q1, Q2, Q3, Q4, Q5, Q7, Q8, Q9, Q10, Q11, Q12, Q13: FQP30N06L; TO254P470X1016X2019-3P
Q6, Q14: FDU3N40TU; TO229P250X658X985-3P
R1, R2, R3, R6, R7, R10, R13, R15, R17, R19, R21, R23, R25, R27: 10k; 0204/7
R4, R5, R8, R9, R11, R12, R14, R16, R18, R20, R22, R24, R26, R28: 1K; 0204/7
RORP: JST-XH-02-PIN-LONG-PAD; JST-XH-02-PACKAGE-LONG-PAD
RRTDS: JST-XH-04-PIN-LONG-PAD; JST-XH-04-PACKAGE-LONG-PAD
STDS: JST-XH-04-PIN-LONG-PAD; JST-XH-04-PACKAGE-LONG-PAD
SUPP: JST-XH-02-PIN-LONG-PAD; JST-XH-02-PACKAGE-LONG-PAD
SWTDS: JST-XH-04-PIN-LONG-PAD; JST-XH-04-PACKAGE-LONG-PAD
TDS1, TDS2: JST-XH-03-PIN-LONG-PAD; JST-XH-03-PACKAGE-LONG-PAD
TS1: JST-XH-03-PIN-LONG-PAD; JST-XH-03-PACKAGE-LONG-PAD
UV: HEADER_POS2_43650-0215; 43650-0215
WV: JST-XH-02-PIN-LONG-PAD; JST-XH-02-PACKAGE-LONG-PAD
WWTDS: JST-XH-04-PIN-LONG-PAD; JST-XH-04-PACKAGE-LONG-PAD

Connections:
+5V: 5VS.P$1 (1), C1.1, C2.1, C3.1, D6.C, D14.C, IC1.14 (VCC), IC2.14 (VCC), IC3.14 (VCC), K1.4 (COIL_2), K2.4 (COIL_2), MTDS.1, MTDS.3, PCB2.AREF, PCB2.VIN, R1.2, R2.2, R3.2, R7.2, R10.2, R13.2, R15.2, R17.2, R19.2, R21.2, R23.2, R25.2, RRTDS.1, RRTDS.3, STDS.1, STDS.3, SWTDS.1, SWTDS.3, TDS1.1, TDS2.1, TS1.1, WWTDS.1, WWTDS.3
+12V: 12VS.P$1 (1), D1.C, D2.C, D3.C, D4.C, D5.C, D7.C, D8.C, D9.C, D10.C, D11.C, D12.C, D13.C, MIXP.1, NP1.1, NP2.1, NP3.1, NP4.1, NP5.1, NP6.1, PHDPP.1, PHUPP.1, R6.2, R27.2, RORP.1, SUPP.1, WV.1
+240VAC: 240ACVS.P$1 (1), K1.5 (COM), K2.5 (COM)
-240VAC: 240ACVS.P$2 (2), HEAT.P$1 (1), UV.P$1 (1)
GND: 5VS.P$2 (2), 12VS.P$2 (2), C1.2, C2.2, C3.2, IC1.7 (GND), IC2.7 (GND), IC3.5 (I), IC3.6 (O), IC3.7 (GND), IC3.8 (O), IC3.9 (I), IC3.10 (O), IC3.11 (I), IC3.12 (O), IC3.13 (I), MTDS.2, PCB2.GND, Q1.3 (S), Q2.3 (S), Q3.3 (S), Q4.3 (S), Q5.3 (S), Q6.3 (S), Q7.3 (S), Q8.3 (S), Q9.3 (S), Q10.3 (S), Q11.3 (S), Q12.3 (S), Q13.3 (S), Q14.3 (S), RRTDS.2, STDS.2, SWTDS.2, TDS1.2, TDS2.2, TS1.2, WWTDS.2
HEATCTL: IC3.3 (I), PCB2.32
MIXPCTL: IC2.5 (I), PCB2.2
MTDO: MTDS.4, PCB2.23
MTT: PCB2.22, TS1.3
N1PP: IC1.1 (I), PCB2.34
N2PP: IC1.3 (I), PCB2.36
N3PP: IC1.5 (I), PCB2.38
N4PP: IC1.9 (I), PCB2.40
N5PP: IC1.11 (I), PCB2.42
N6PP: IC1.13 (I), PCB2.44
unnamed: D2.A, MIXP.2, Q2.2 (D)
unnamed: D3.A, NP1.2, Q3.2 (D)
unnamed: IC2.8 (O), R1.1, R5.1
unnamed: Q2.1 (G), R8.2
unnamed: Q1.1 (G), R5.2
unnamed: IC1.2 (O), R3.1, R4.1
unnamed: K1.3 (NO), UV.P$2 (2)
unnamed: Q3.1 (G), R4.2
unnamed: IC2.6 (O), R2.1, R8.1
unnamed: D1.A, Q1.2 (D), SUPP.2
unnamed: D4.A, NP3.2, Q4.2 (D)
unnamed: IC1.6 (O), R7.1, R9.1
unnamed: Q6.1 (G), R11.2
unnamed: Q4.1 (G), R9.2
unnamed: D5.A, NP5.2, Q5.2 (D)
unnamed: IC1.10 (O), R10.1, R12.1
unnamed: IC3.2 (O), R6.1, R11.1
unnamed: Q5.1 (G), R12.2
unnamed: D7.A, PHDPP.2, Q7.2 (D)
unnamed: IC2.2 (O), R13.1, R14.1
unnamed: D6.A, K1.1 (COIL_1), Q6.2 (D)
unnamed: Q7.1 (G), R14.2
unnamed: D8.A, NP2.2, Q8.2 (D)
unnamed: IC1.4 (O), R15.1, R16.1
unnamed: Q8.1 (G), R16.2
unnamed: D9.A, NP4.2, Q9.2 (D)
unnamed: IC1.8 (O), R17.1, R18.1
unnamed: Q9.1 (G), R18.2
unnamed: D10.A, NP6.2, Q10.2 (D)
unnamed: IC1.12 (O), R19.1, R20.1
unnamed: Q10.1 (G), R20.2
unnamed: D11.A, PHUPP.2, Q11.2 (D)
unnamed: IC2.4 (O), R21.1, R22.1
unnamed: Q11.1 (G), R22.2
unnamed: D12.A, Q12.2 (D), RORP.2
unnamed: IC2.10 (O), R23.1, R24.1
unnamed: Q12.1 (G), R24.2
unnamed: D13.A, Q13.2 (D), WV.2
unnamed: IC2.12 (O), R25.1, R26.1
unnamed: Q13.1 (G), R26.2
unnamed: D14.A, K2.1 (COIL_1), Q14.2 (D)
unnamed: HEAT.P$2 (2), K2.3 (NO)
unnamed: Q14.1 (G), R28.2
unnamed: IC3.4 (O), R27.1, R28.1
PHDPP: IC2.1 (I), PCB2.46
PHUPP: IC2.3 (I), PCB2.48
RORPCTL: IC2.11 (I), PCB2.4
RRTDO: PCB2.27, RRTDS.4
STDO: PCB2.25, STDS.4
SUPPCTL: IC2.9 (I), PCB2.3
SWTDO: PCB2.31, SWTDS.4
TDS1: PCB2.24, TDS1.3
TDS2: PCB2.26, TDS2.3
UVCTL: IC3.1 (I), PCB2.30
WVCTL: IC2.13 (I), PCB2.49
WWTDO: PCB2.29, WWTDS.4

Notes on the sheet:
Nutrient Pumps
Other Pumps and Valves

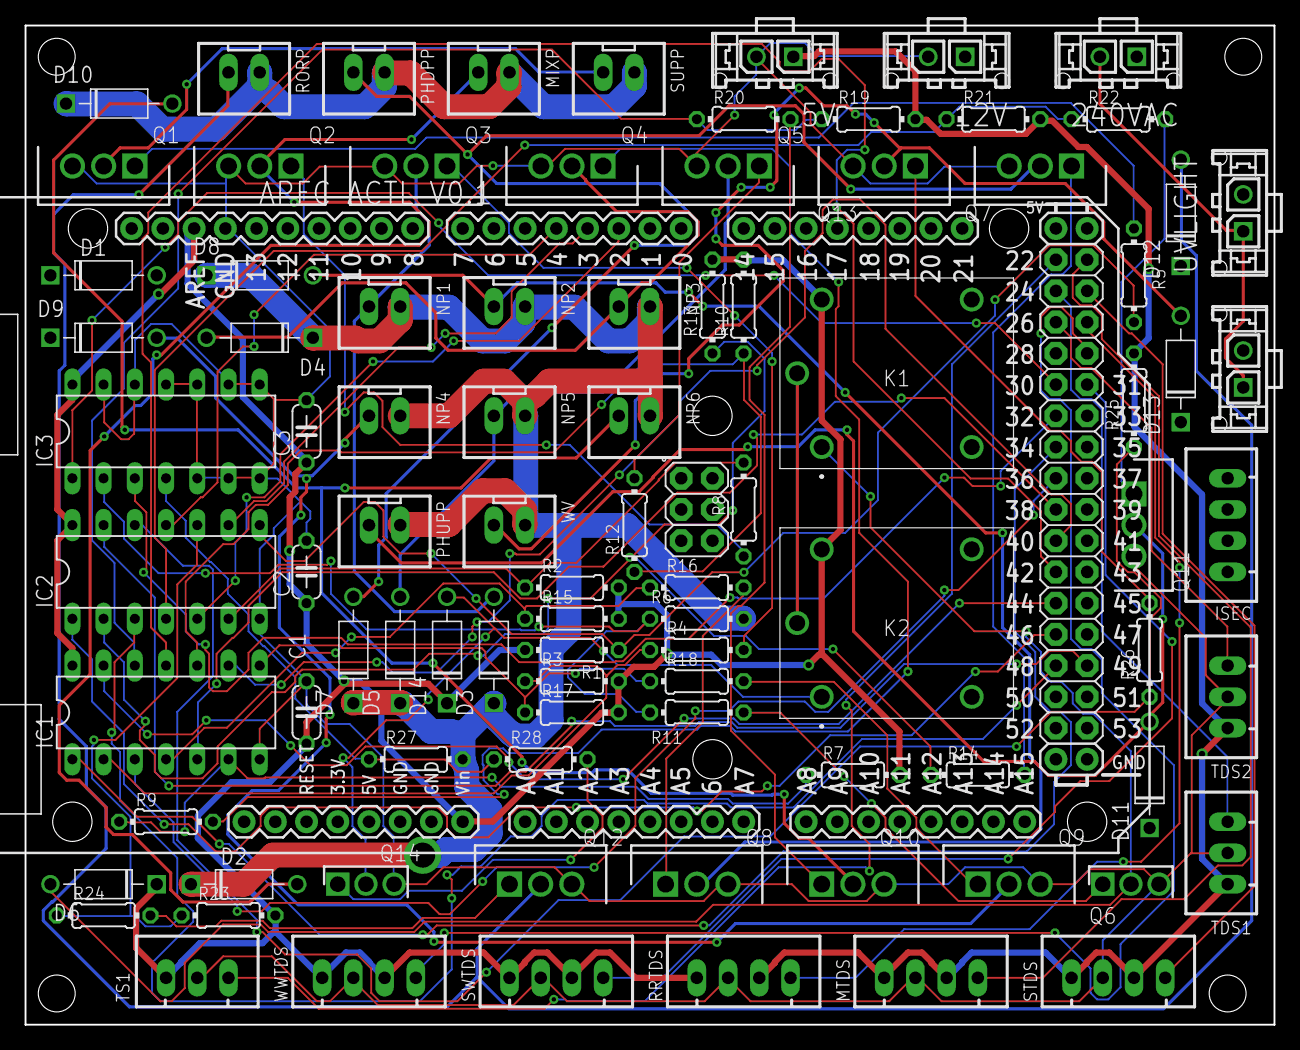
[picture p11: board Nutrient Management Control.brd from above]

Board: 2 copper layers, 101.6 x 81.3 mm, 91 parts (0 on the bottom side), 71 nets.
