rcjcooke/apfc/electronics/Aeroponics Control.brd

## EAGLE design electronics/Aeroponics Control.brd (2024-09-27)

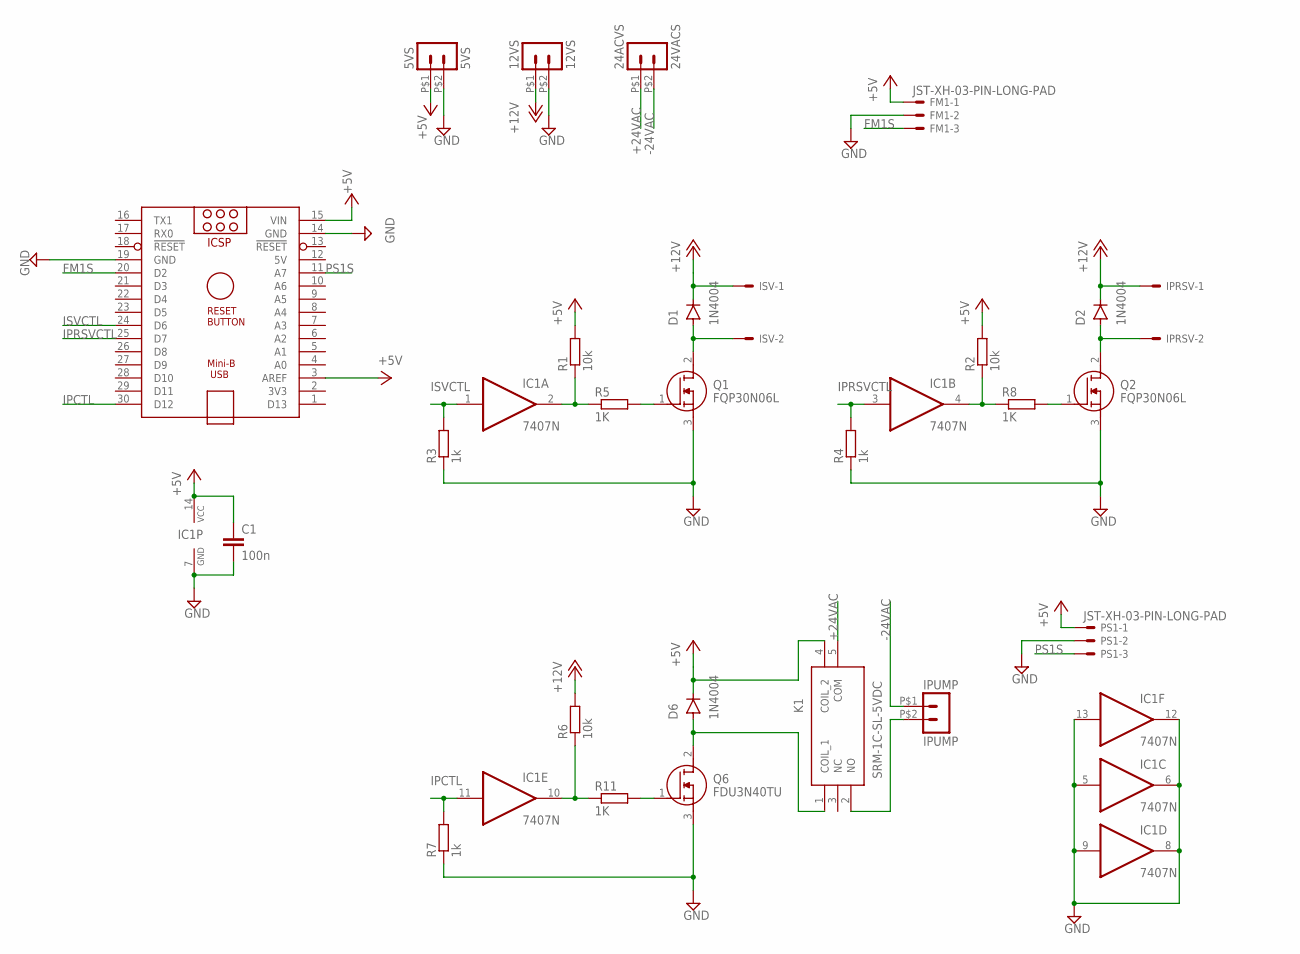
[picture p12: schematic Aeroponics Control.sch]

Parts:
5VS: 5VS; 43650-0215
12VS: 12VS; 43650-0215
24ACVS: 24VACS; 43650-0215
C1: 100n; C050-024X044
D1, D2, D6: 1N4004; DO-41
FM1: JST-XH-03-PIN-LONG-PAD; JST-XH-03-PACKAGE-LONG-PAD
IC1: 7407N; DIL14
IPRSV: JST-XH-02-PIN-LONG-PAD; JST-XH-02-PACKAGE-LONG-PAD
IPUMP: IPUMP; 43650-0215
ISV: JST-XH-02-PIN-LONG-PAD; JST-XH-02-PACKAGE-LONG-PAD
K1: SRM-1C-SL-5VDC; SRM1CSL5VDC
PCB1: ARDUINO_NANOARDUINO_NANO_HEADERS; ARDUINO_NANO
PS1: JST-XH-03-PIN-LONG-PAD; JST-XH-03-PACKAGE-LONG-PAD
Q1, Q2: FQP30N06L; TO254P470X1016X2019-3P
Q6: FDU3N40TU; TO229P250X658X985-3P
R1, R2, R6: 10k; 0204/7
R3, R4, R7: 1k; 0204/7
R5, R8, R11: 1K; 0204/7

Connections:
5V: PCB1.12 (5V)
+5V: 5VS.P$1 (1), C1.1, D6.C, FM1.1, IC1.14 (VCC), K1.4 (COIL_2), PCB1.3 (AREF), PCB1.15 (VIN), PS1.1, R1.2, R2.2
+12V: 12VS.P$1 (1), D1.C, D2.C, IPRSV.1, ISV.1, R6.2
+24VAC: 24ACVS.P$1 (1), K1.5 (COM)
-24VAC: 24ACVS.P$2 (2), IPUMP.P$1 (1)
FM1S: FM1.3, PCB1.20 (D2)
GND: 5VS.P$2 (2), 12VS.P$2 (2), C1.2, FM1.2, IC1.5 (I), IC1.6 (O), IC1.7 (GND), IC1.8 (O), IC1.9 (I), IC1.12 (O), IC1.13 (I), PCB1.14 (GND), PCB1.19 (GND), PS1.2, Q1.3 (S), Q2.3 (S), Q6.3 (S), R3.1, R4.1, R7.1
IPCTL: IC1.11 (I), PCB1.30 (D12), R7.2
IPRSVCTL: IC1.3 (I), PCB1.25 (D7), R4.2
ISVCTL: IC1.1 (I), PCB1.24 (D6), R3.2
unnamed: D2.A, IPRSV.2, Q2.2 (D)
unnamed: IC1.2 (O), R1.1, R5.1
unnamed: Q2.1 (G), R8.2
unnamed: Q1.1 (G), R5.2
unnamed: IPUMP.P$2 (2), K1.2 (NO)
unnamed: IC1.4 (O), R2.1, R8.1
unnamed: D1.A, ISV.2, Q1.2 (D)
unnamed: Q6.1 (G), R11.2
unnamed: IC1.10 (O), R6.1, R11.1
unnamed: D6.A, K1.1 (COIL_1), Q6.2 (D)
PS1S: PCB1.11 (A7), PS1.3

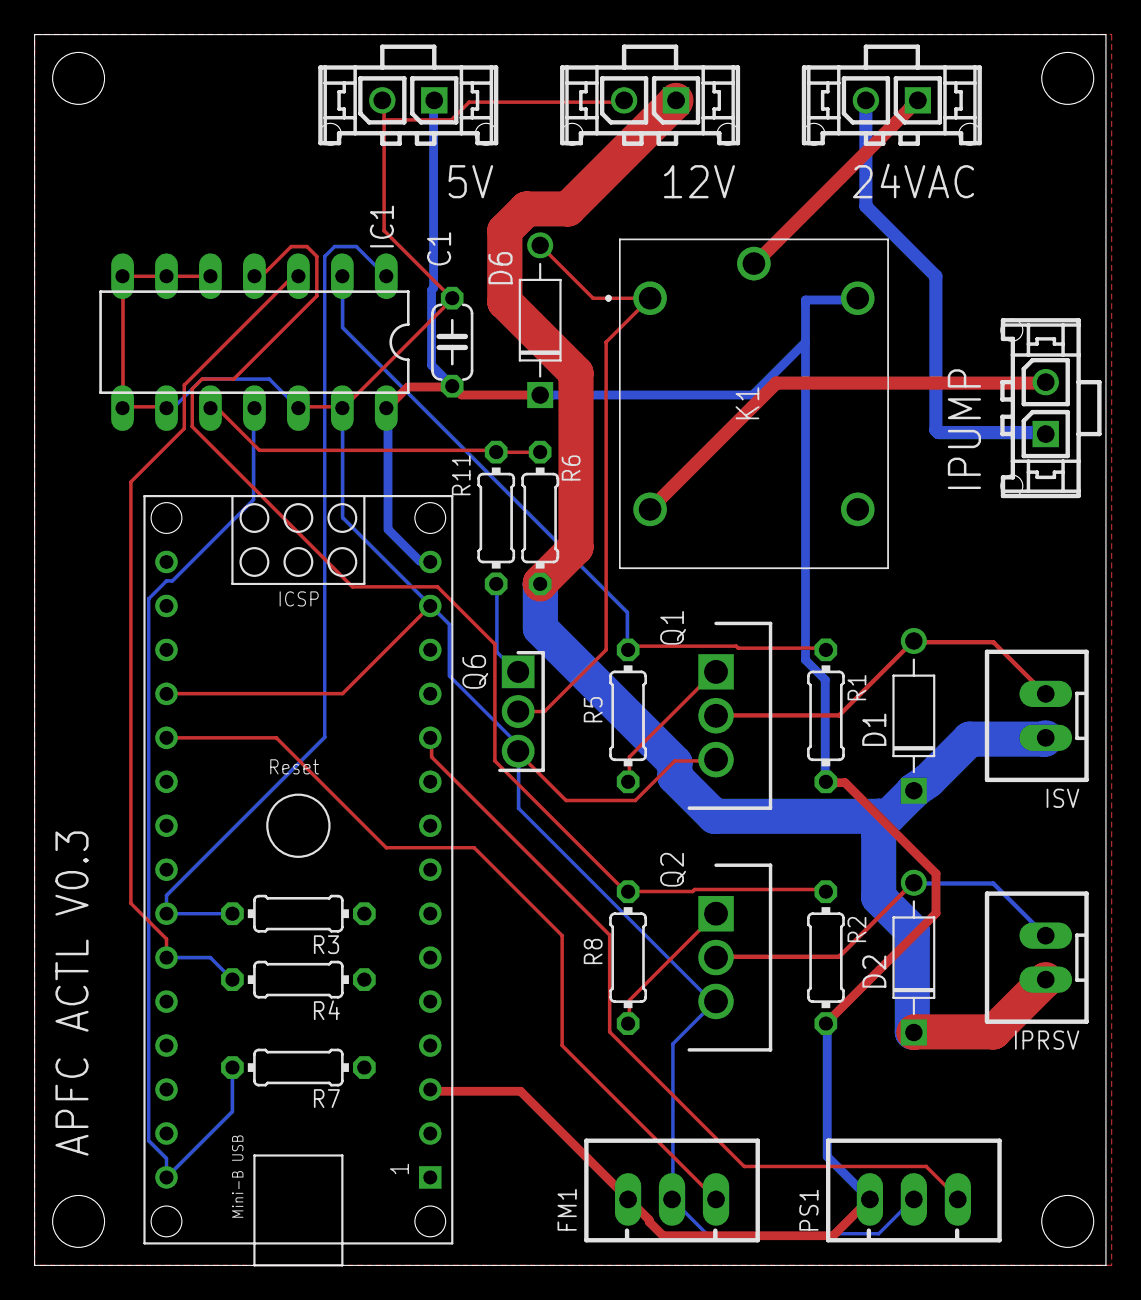
[picture p13: board Aeroponics Control.brd from above]

Board: 2 copper layers, 61.9 x 71.1 mm, 27 parts (0 on the bottom side), 20 nets.
