rcjcooke/apfc/software/aero_ctrl/src/IrrigationPressureController.cpp

#include "IrrigationPressureController.hpp"

/************************
 * Constants
 ************************/
namespace IrrigationPressureControllerNS {
  /* Sensor Calibration */
  // Maximum pressure the sensor detects / PSI
  const int MAX_PRESSURE_PSI = 150;
  /* System pressures */
  // The pressure below which the irrigation pump should be turned back on / PSI
  const int MIN_PRESSURE_PSI = 80;
  // While I would like this to be 100 PSI, the compressor I have just can't seem to achieve it. 
  const int TARGET_PRESSURE_PSI = 93;
  // The pressure at which the drain valve should be opened to relieve pressure / PSI
  const int OVER_PRESSURE_PSI = 120;
}

/*******************************
 * Constructors
 *******************************/
// Basic constructor
IrrigationPressureController::IrrigationPressureController(uint8_t pressureSensorPin, uint8_t drainValveControlPin, uint8_t irrigationCompressorControlPin) : AlarmGenerator('I', 1) {
  mPressureSensor = new PressureSensor(pressureSensorPin, IrrigationPressureControllerNS::MAX_PRESSURE_PSI);

  mDrainValveControlPin = drainValveControlPin;
  mIrrigationCompressorControlPin = irrigationCompressorControlPin;

  pinMode(mDrainValveControlPin, OUTPUT);
  pinMode(mIrrigationCompressorControlPin, OUTPUT);

  turnOffIrrigationCompressor();
  closeDrainValve();
}

/*******************************
 * Getters / Setters
 *******************************/
// True when the valve is open (i.e. draining is in progress)
bool IrrigationPressureController::isDrainValveOpen() const {
  return mDrainValveOpen;
};

// True when the irrigation pump is on (building pressure)
bool IrrigationPressureController::isIrrigationCompressorOn() const {
  return mIrrigationCompressorOn;
}

// Get the current irrigation system pressure / PSI
double IrrigationPressureController::getPressurePSI() const {
  return mPressureSensor->getPressurePSI();
}

// Get the PressureSensor - useful for debug purposes
PressureSensor* IrrigationPressureController::getPressureSensor() const {
  return mPressureSensor;
}

/*******************************
 * Actions
 *******************************/
// Called every microcontroller main program loop - controls the pressure in the irrigation system
void IrrigationPressureController::controlLoop() {
  
  // Get updated pressure readings
  mPressureSensor->readPressure();
  float pressurePSI = mPressureSensor->getPressurePSI();

  if (pressurePSI < IrrigationPressureControllerNS::OVER_PRESSURE_PSI) {
    clearAlarm(OVER_PRESSURE_ALARM); // Just in case it's been triggered
  }
  
  if (pressurePSI <= IrrigationPressureControllerNS::MIN_PRESSURE_PSI) {
    closeDrainValve(); // Just in case it's open
    turnOnIrrigationCompressor();
  } else if (pressurePSI >= IrrigationPressureControllerNS::TARGET_PRESSURE_PSI) {
    // Target pressure reached
    turnOffIrrigationCompressor();
  } else if (pressurePSI >= IrrigationPressureControllerNS::OVER_PRESSURE_PSI) {
    /*
    Something's gone wrong and the pressure is still building, 
    open the drain valve to relieve pressure and raise the alarm
    */
    openDrainValve();
    triggerAlarm(OVER_PRESSURE_ALARM);
  }
 
}

// Open drain valve
void IrrigationPressureController::openDrainValve() {
  digitalWrite(mDrainValveControlPin, HIGH);
  mDrainValveOpen = true;
}

// Close drain valve
void IrrigationPressureController::closeDrainValve() {
  digitalWrite(mDrainValveControlPin, LOW);
  mDrainValveOpen = false;
}

// Turn on the Irrigation Pump (builds up pressure)
void IrrigationPressureController::turnOnIrrigationCompressor() {
  digitalWrite(mIrrigationCompressorControlPin, HIGH);
  mIrrigationCompressorOn = true;
}

// Turn off the Irrigation Pump
void IrrigationPressureController::turnOffIrrigationCompressor() {
  digitalWrite(mIrrigationCompressorControlPin, LOW);
  mIrrigationCompressorOn = false;
}
