rcjcooke/apfc/(commit log)

2022-08-25 Initial framework
    [Aeroponics Control.brd, Aeroponics Control.sch]
2022-08-27 Added first couple of control flow segments
2022-08-29 First cut of pressure sensor calibration tool
2022-09-20 Electronics tested. Added calibration and debug.
    [436450200.stp, Aeroponics Control.brd, Aeroponics Control.sch]
2022-09-21 Fixed linking and missed scoping error
    [SolutionTanksController.cpp, SprayController.cpp, SprayController.hpp]
2023-04-09 Added BOM and process flow diagram
    [V1 BOM.xlsx]
2023-04-18 Renamed Process Flow Diagram. Added some more BOM items.
    [V1 BOM.xlsx]
2023-04-22 Added filters to pipe inlets in case of algae
2023-04-30 Laser cutting templates and 3D printing GCode
    [I_Management_FMP.dxf, I_Management_FP.dxf, V1 BOM.xlsx, WP-FP-Bottom-Sketch.dxf, WP-FP-Top-Sketch.dxf]
2023-06-15 Updated aeroponics control electronics.
    [Aeroponics Control.brd, Aeroponics Control.sch, Nutrient Management Control.brd, Nutrient Management Control.sch]
2023-06-16 Updated logo to include lens
2023-06-18 Picked out components for nutrient management
    [V1 BOM.xlsx]
2023-06-18 Just Microcontroller and control signals left todo
    [Nutrient Management Control.brd, Nutrient Management Control.sch]
2023-06-21 First cut of Nutrient Management electronics
    [Nutrient Management Control.brd, Nutrient Management Control.sch]
2023-08-26 Prevent buffer overflow. More debug.
    [main.cpp]
2023-08-26 Added pull down resistors to Arduino output pins
    [Aeroponics Control.brd, Aeroponics Control.sch]
2023-08-27 Added PRV return check valve
2023-08-28 Added TDS sensor for post RO filter
2024-09-25 8695xzbdw: Fix for flush valve opening on microcontroller reset
    [Aeroponics Control.brd, Aeroponics Control.sch]
2024-09-26 First cut of SerialDebuggerInput
2024-09-26 Integrated new SerialDebuggerInput and renamed irrigation pump to compressor
2024-09-27 Fixed relay library component pin mapping NC and NO pins
2024-09-27 Fixed FMS1 pin assignment on Nano. Incorpated fixed Relay library component.
    [Aeroponics Control.brd, Aeroponics Control.sch]
2024-09-27 Added ability to put the raw flow sensor pulse count on the debug interface
2024-10-03 Lowered pressure upper bound to adjust for compressor capability.
2024-10-03 First cut of the nutrient controller post 2024 project restart
2024-10-04 First cut of V2.2
    [Nutrient Management Control v2.2.brd, Nutrient Management Control v2.2.sch]
2024-10-04 Added Grove connector
2024-10-05 Added ability to define whether the sensor returns real-time or processed data
2024-10-05 Correcting pins, debug and naming conventions
    [Nutrient Management Control v2.2.brd, Nutrient Management Control v2.2.sch]
2024-10-06 Added throttle into read method and corrected distance return types to float.
2024-10-14 Fixed bug causing Arduino resets on alarm triggering
2024-10-14 Type and value cleanups. Also fix to make sure pump is _actually_ turned off on initialisation.
    [SolutionTanksController.cpp, SolutionTanksController.hpp]
2024-10-14 Consolidated User input and control functionality into SerialDebugger. And pre-empted function null pointer problem.
    [main.cpp]
2024-10-17 Added first cut of SPI2UART board on headers
2024-10-17 First cut of Nutrient Management with multi UART breakout boards
    [Nutrient Management Control v2.2.brd, Nutrient Management Control v2.2.sch, Nutrient Management Control.brd, Nutrient Management Control.sch]
2024-10-17 Added Rowland Technologies MultiUART Arduino library
2024-10-17 Updated library to use more Arduino appropriate types
2024-10-17 Added first cut of interfaces that abstract a single UART interface out of the MultiUART instance
2024-10-17 New sensor interfaces that talk via a MultiUART board
2024-10-23 Learnings from MULTIUART testing applied. Lots of changes. Getting depths from 2 sensors works.
2024-10-23 Cleaned up debug for next stage
2024-10-23 Added UV steriliser. Changed MULTIUART CS to correct pin 6 rather than 53.
    [SolutionTanksController.cpp, SolutionTanksController.hpp, main.cpp]
2024-10-23 Added UV Steriliser
    [Nutrient Management Control v2.2.brd, Nutrient Management Control v2.2.sch]
2024-11-01 Put run-off pump after filter so it pulls through the filter rather than pushes through it
2025-07-20 Cleaning up pressure_calc unused files
2025-07-20 Sorting out Nutrient Control Electronics
    [Nutrient Management Control v2.2.brd, Nutrient Management Control v2.2.sch]
2025-07-20 Created a new front mount plate for the Water Purification
    [WP-FrontMountPlate.dxf]
2025-07-22 Added first cut of TDS sensor class
2025-07-23 intro. apfc ns. Refactored to create and use StandardController. Style fixes.
    [SolutionTanksController.cpp, SolutionTanksController.hpp, StandardController.cpp, StandardController.hpp, main.cpp]
2025-07-23 First cut of Water Supply Controller - tank depth alerting only.
2025-07-23 Added first cut of onewire address finder utility
2025-07-23 added first cut of address finder utility
2025-07-23 Moved depth sensor reading checking to a utility function on the sensor. Filled in missing virtuals on WaterSupplyController.
    [SolutionTanksController.cpp, SolutionTanksController.hpp, WaterSupplyController.cpp, WaterSupplyController.hpp]
2025-07-23 Added temperature sensor libraries
2025-07-23 Fixed passing the sensor address across to water supply controller
    [WaterSupplyController.cpp, WaterSupplyController.hpp, main.cpp]
2025-07-23 Added temp sensors in
2025-07-23 Added filter replacement checking and flush scheduling
    [WaterSupplyController.cpp, WaterSupplyController.hpp]
